kkaya674/AntiaTech/Others/Çizimler/raspBi_box/images/DSC_0020.JPG

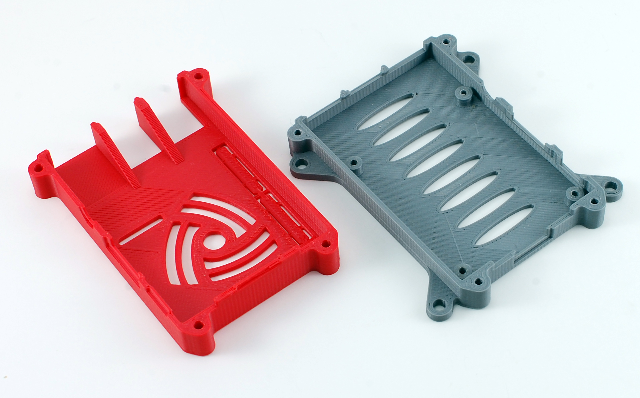
Others/Çizimler/raspBi_box/images/DSC_0020.JPG
