kkaya674/AntiaTech/Others/Çizimler/raspBi_box/images/DSC_0039.JPG

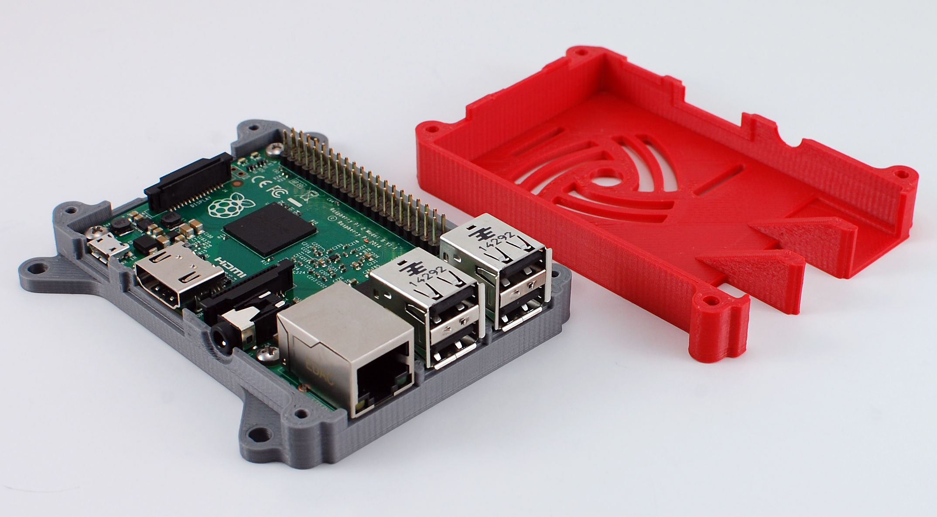
Others/Çizimler/raspBi_box/images/DSC_0039.JPG
