kkaya674/AntiaTech/README.md

# AntiaTech
EE493 Project

Afer Olkay Başak Koca Çağrı Arı Kubilay Kaya Rana Böğrekci
