kkaya674/AntiaTech/Others/Arduino_Vibration&Servo/README

These codes are for the communication between Arduino and other components.
