kkaya674/AntiaTech/Others/MotorSürücü/Faydalı Şeyler/Ekran Resmi 2022-11-27 14.13.48.png

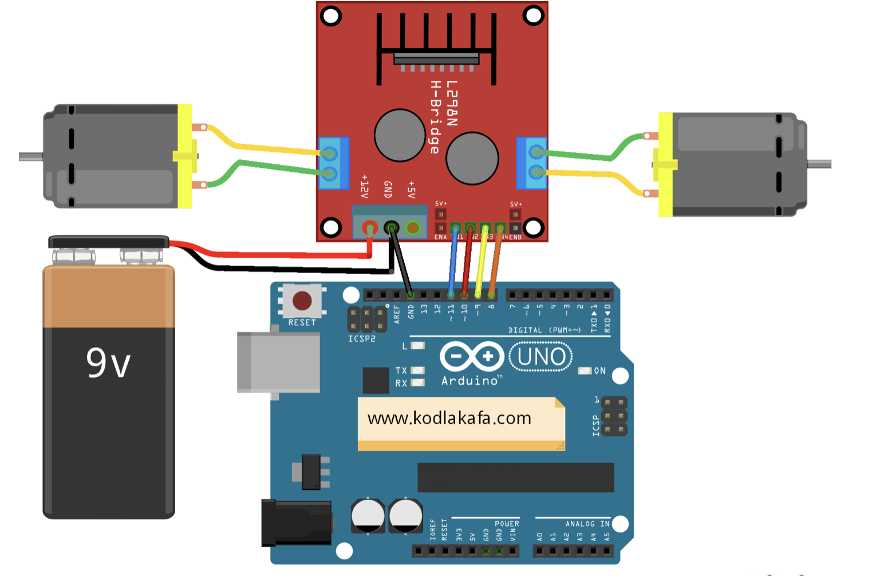
Others/MotorSürücü/Faydalı Şeyler/Ekran Resmi 2022-11-27 14.13.48.png
