kkaya674/AntiaTech/Others/Çizimler/raspBi_box/images/25mm-no-fan.png

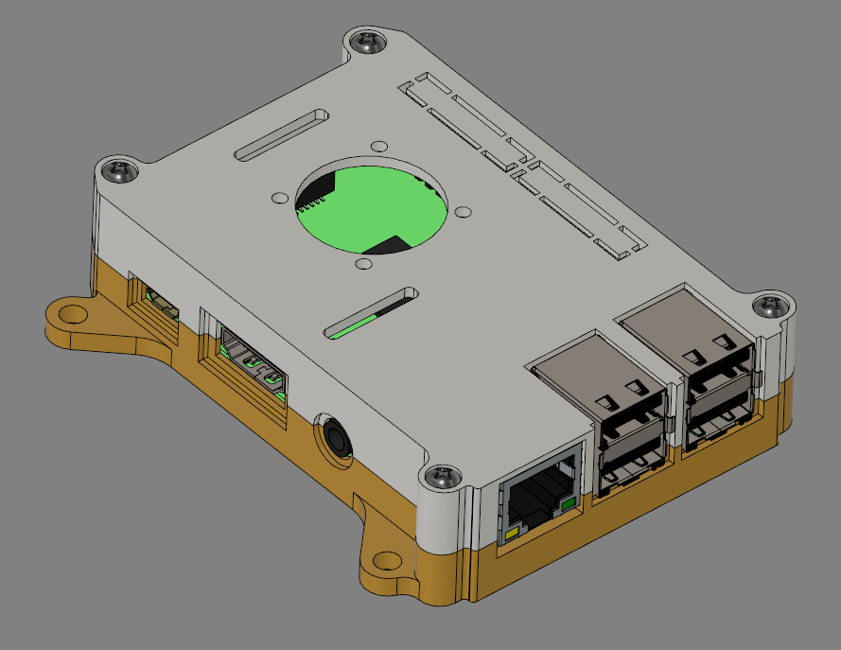
Others/Çizimler/raspBi_box/images/25mm-no-fan.png
