kkaya674/AntiaTech/Others/Çizimler/raspBi_box/images/100mm-VESA.png

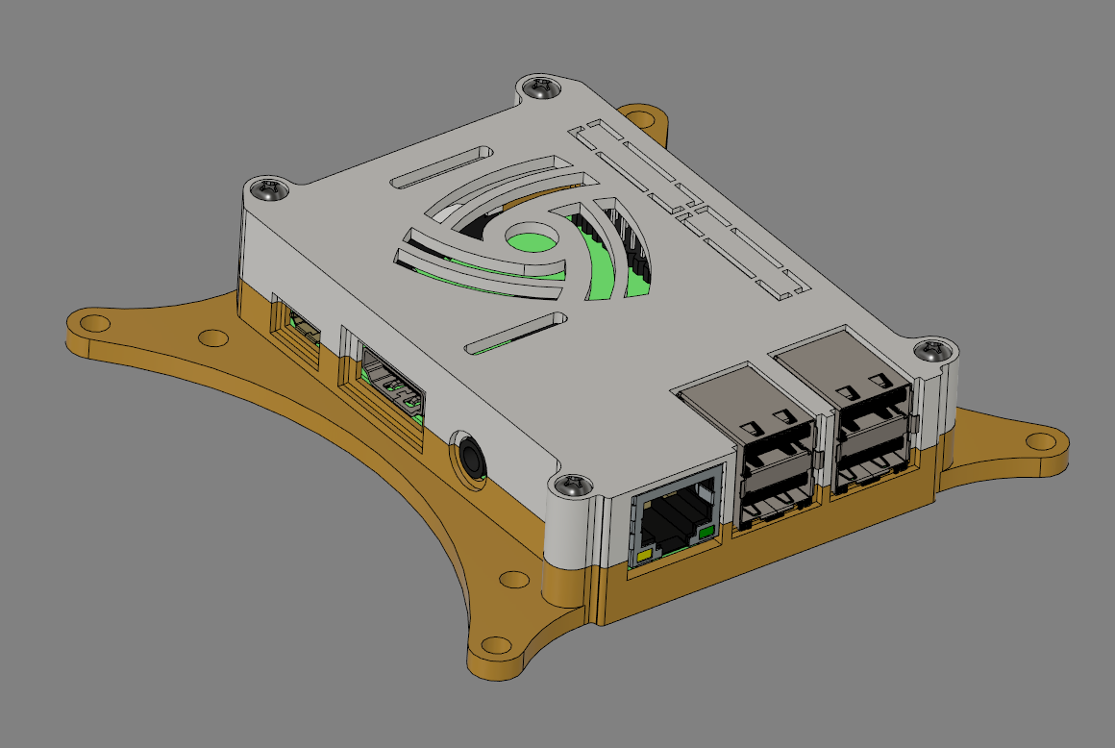
Others/Çizimler/raspBi_box/images/100mm-VESA.png
