kkaya674/AntiaTech/Others/Çizimler/raspBi_box/images/8020-mount.png

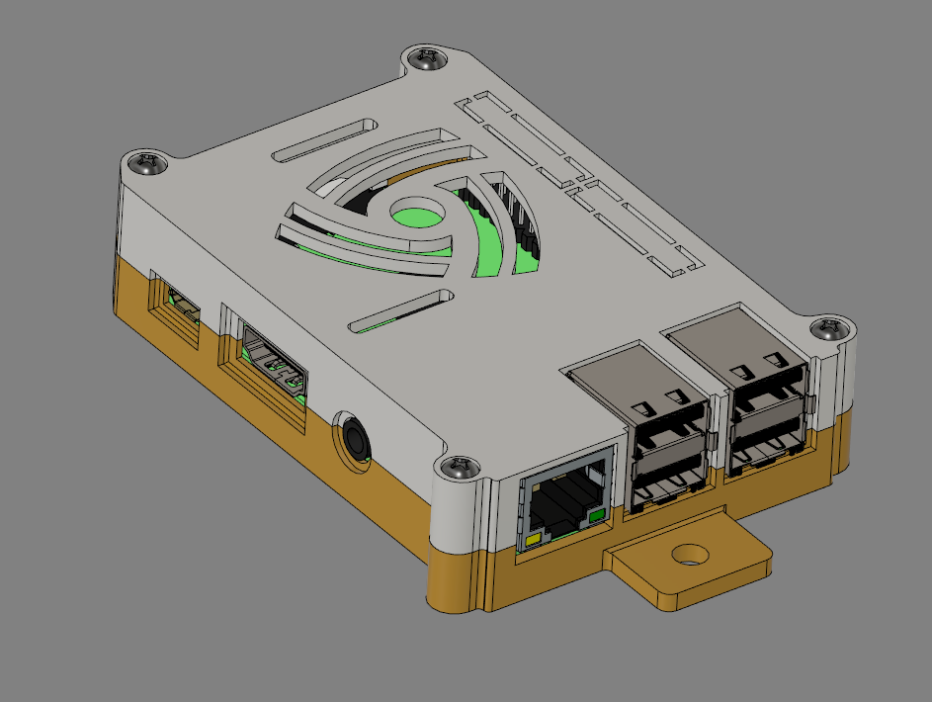
Others/Çizimler/raspBi_box/images/8020-mount.png
