kkaya674/AntiaTech/Others/Çizimler/raspBi_box/images/DSC_0007.JPG

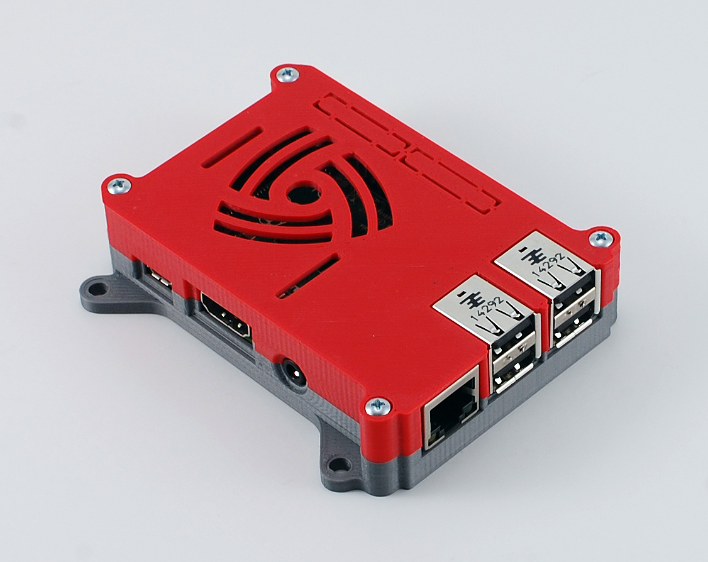
Others/Çizimler/raspBi_box/images/DSC_0007.JPG
