kkaya674/AntiaTech/Others/Çizimler/raspBi_box/images/DSC_0016.JPG

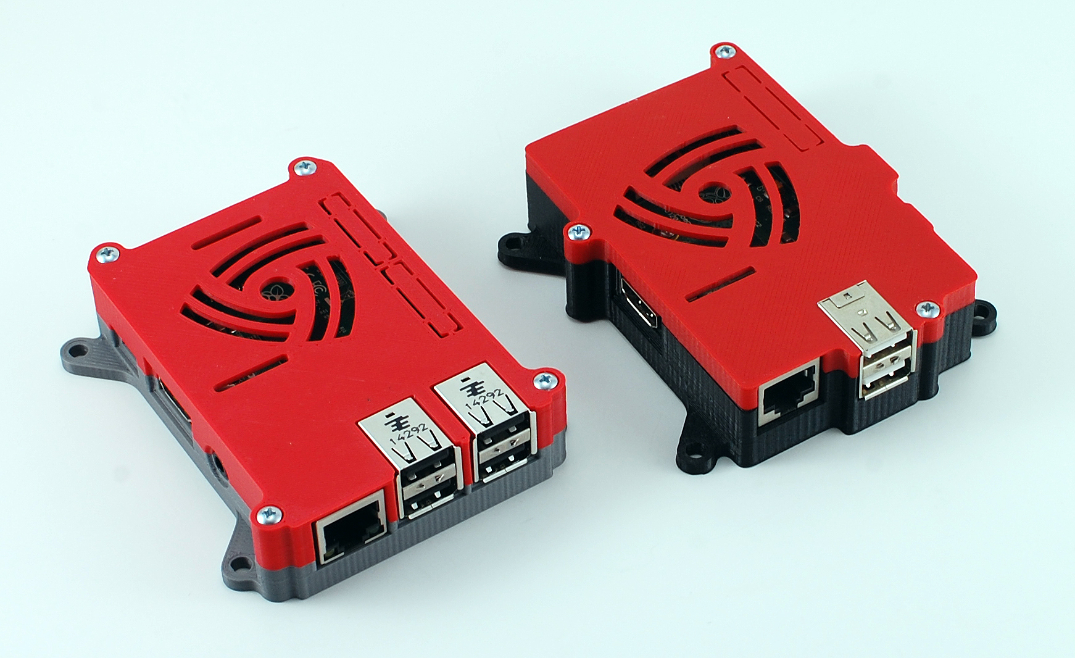
Others/Çizimler/raspBi_box/images/DSC_0016.JPG
