kkaya674/AntiaTech/Others/Çizimler/raspBi_box/images/DSC_0027.JPG

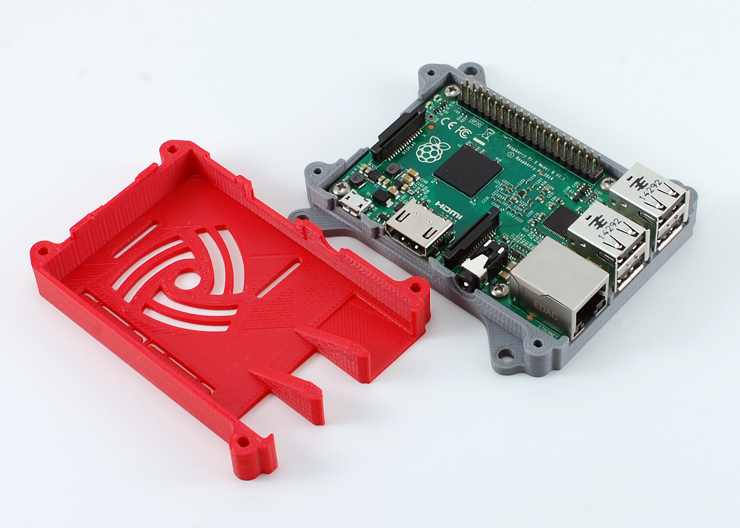
Others/Çizimler/raspBi_box/images/DSC_0027.JPG
