kkaya674/AntiaTech/Others/Çizimler/raspBi_box/images/rpi2-bottom_100mm-vesa_netfabb.png

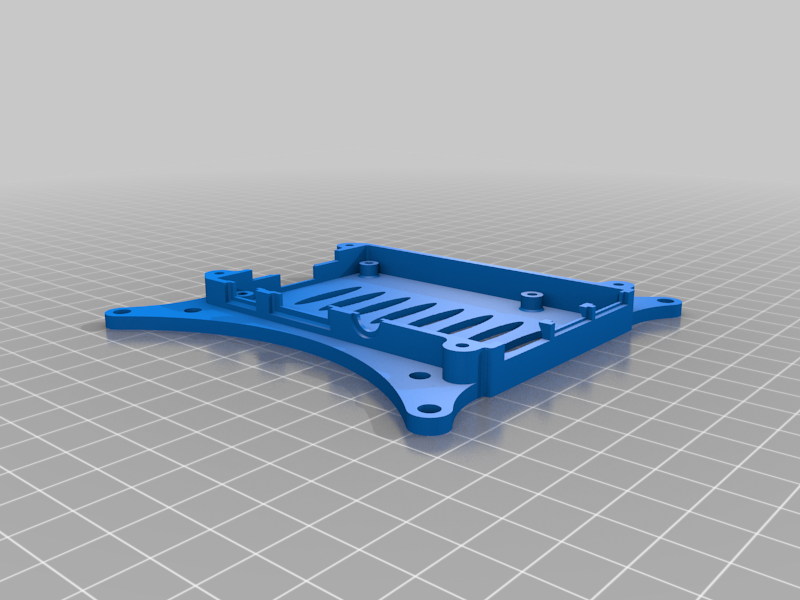
Others/Çizimler/raspBi_box/images/rpi2-bottom_100mm-vesa_netfabb.png
