kkaya674/AntiaTech/Others/Çizimler/raspBi_box/images/RPi2-case_stl.JPG

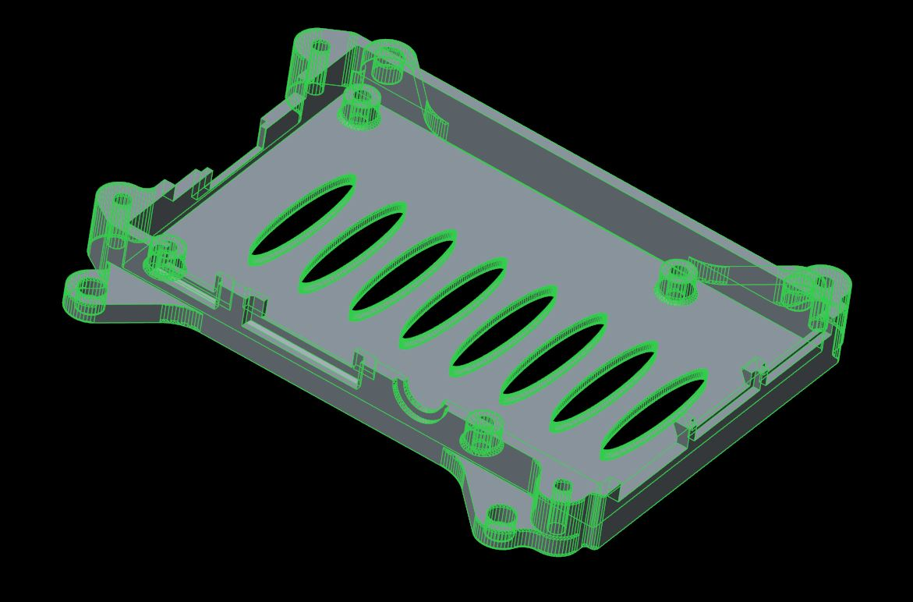
Others/Çizimler/raspBi_box/images/RPi2-case_stl.JPG
