kkaya674/AntiaTech/Others/Çizimler/raspBi_box/images/rpi2-top_netfabb.png

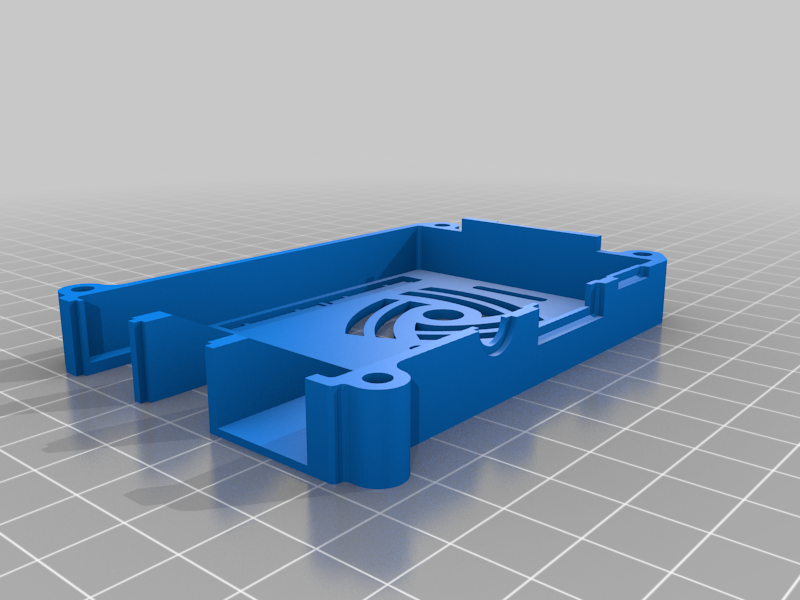
Others/Çizimler/raspBi_box/images/rpi2-top_netfabb.png
