kkaya674/AntiaTech/Others/Çizimler/raspBi_box/images/RPi-1.JPG

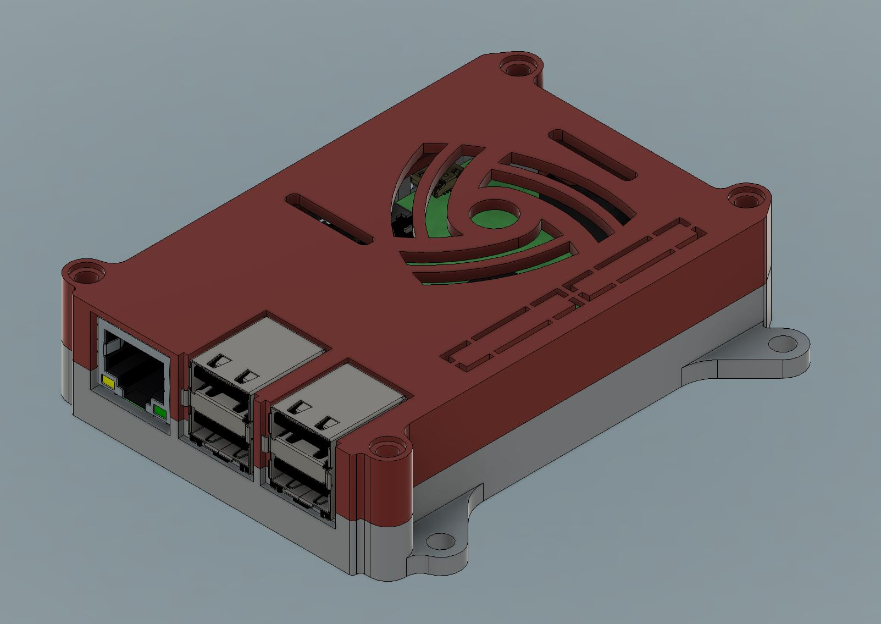
Others/Çizimler/raspBi_box/images/RPi-1.JPG
