kkaya674/AntiaTech/Others/Çizimler/raspBi_box/images/Standard_75mm-VESA.png

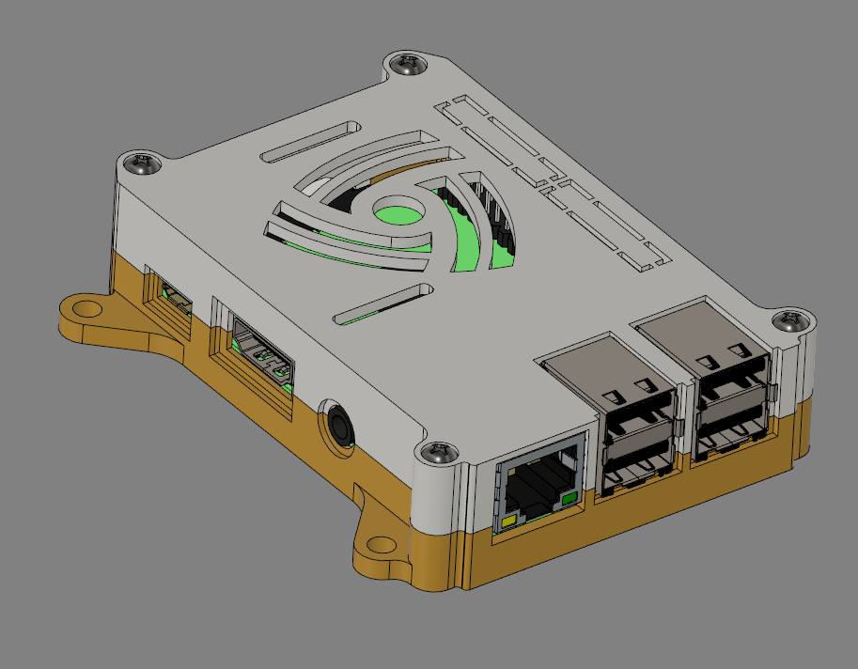
Others/Çizimler/raspBi_box/images/Standard_75mm-VESA.png
