kkaya674/AntiaTech/Reports/grafikler/Number of Ball per 15 Seconds vs Motor Voltage.png

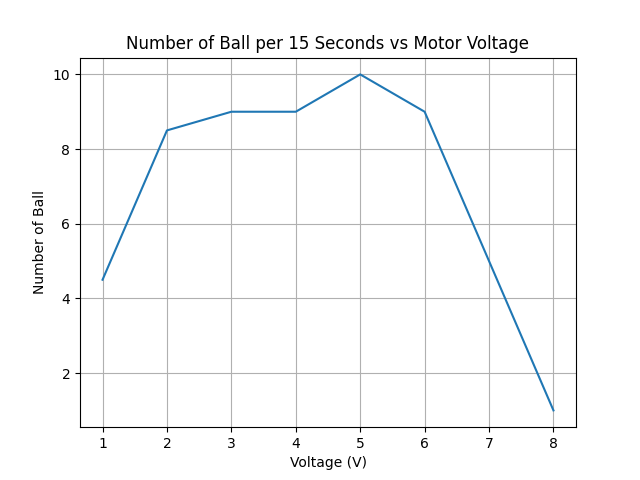
Reports/grafikler/Number of Ball per 15 Seconds vs Motor Voltage.png
