kkaya674/AntiaTech/Reports/grafikler/Speed vs Current.png

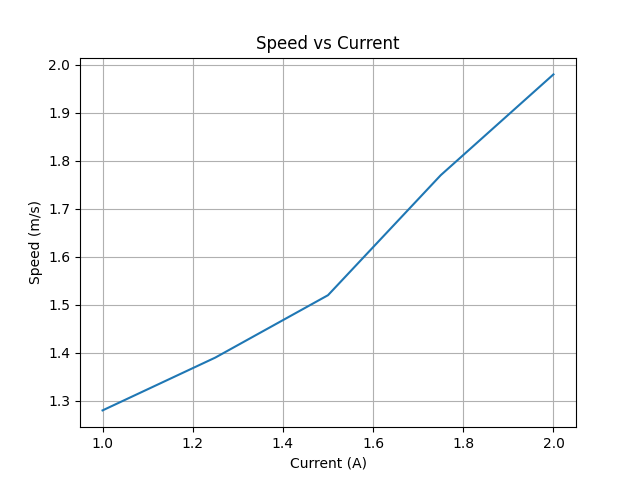
Reports/grafikler/Speed vs Current.png
