kkaya674/AntiaTech/TableTennisBallTracker/resources/renkliToplar.png

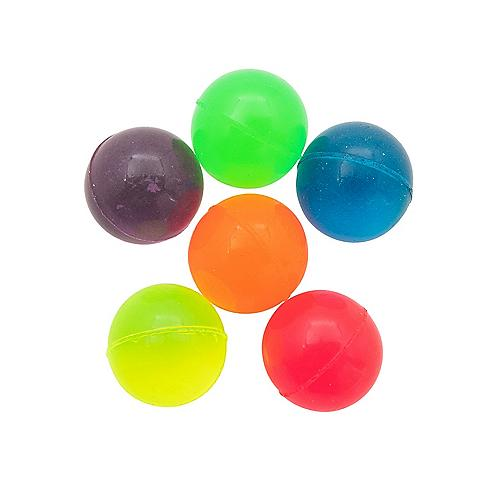
TableTennisBallTracker/resources/renkliToplar.png
