kkaya674/AntiaTech/Others/MotorSürücü/yeniNamlu_obj_raw.stl

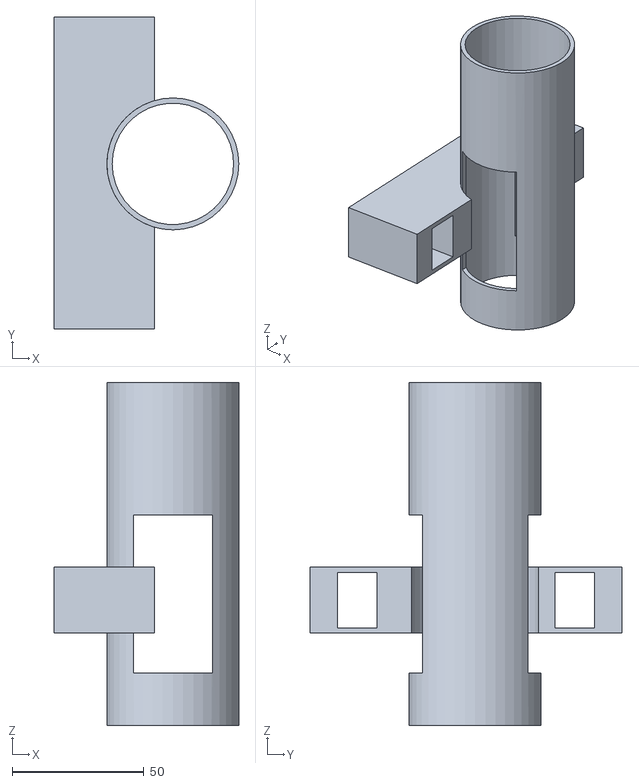
[picture p49: CAD file, 2022-12-27]
Others/MotorSürücü/yeniNamlu_obj_raw.stl
70.0 x 118.3 x 130.0
