kkaya674/AntiaTech/Others/Çizimler/motor yuvası vertical v3.stl

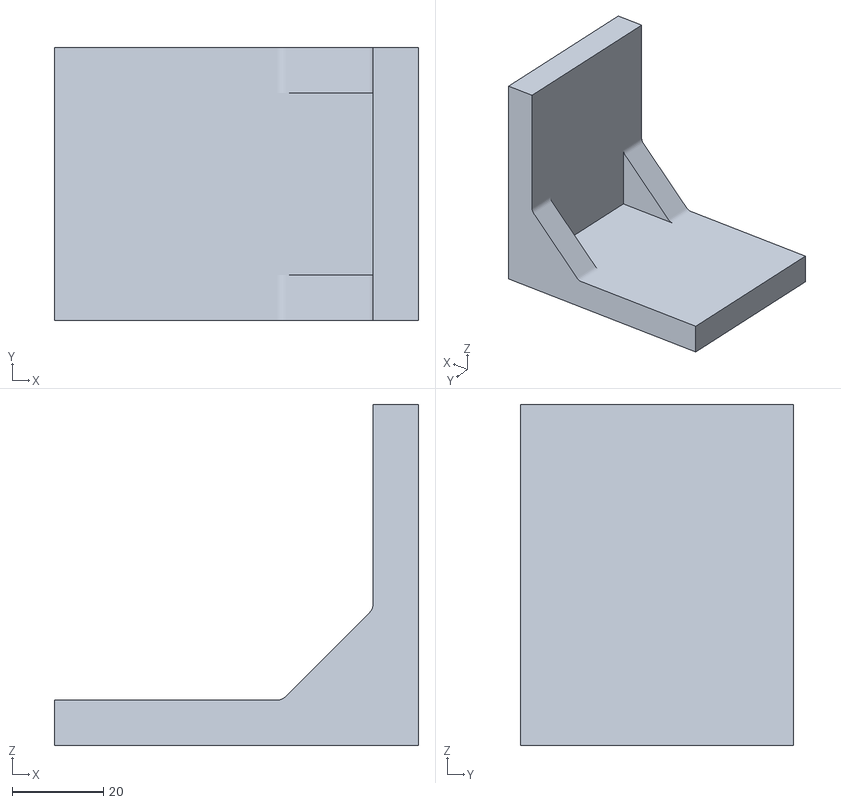
[picture p50: CAD file, 2023-05-10]
Others/Çizimler/motor yuvası vertical v3.stl
80.0 x 60.0 x 75.0
