kkaya674/AntiaTech/Others/Çizimler/raspBi_box/files/rpi2-top.stp

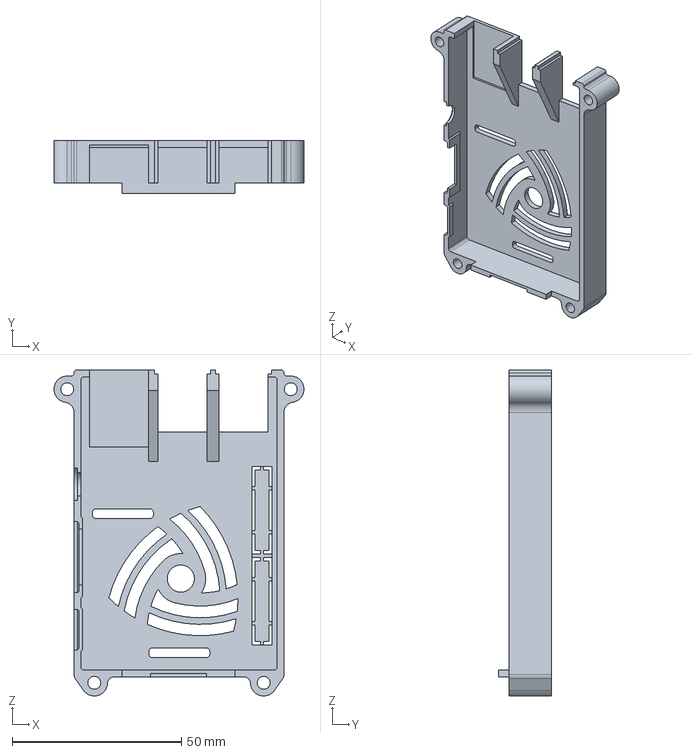
[picture p51: CAD file, 2023-05-13]
Others/Çizimler/raspBi_box/files/rpi2-top.stp
73.8 x 15.5 x 96.2 mm
