kkaya674/AntiaTech/YeniÇizimler/motoryuva2.stl

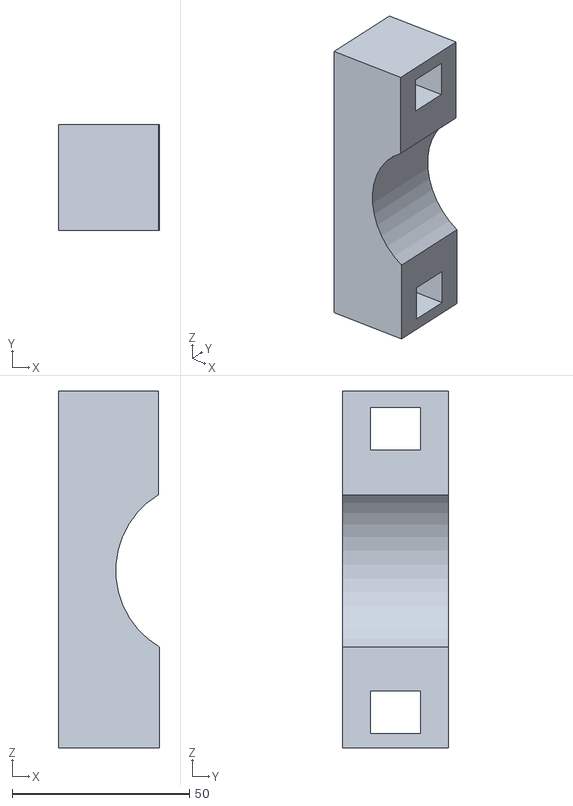
[picture p52: CAD file, 2023-05-27]
YeniÇizimler/motoryuva2.stl
28.6 x 30.0 x 100.6
