kkaya674/AntiaTech/Others/Çizimler/raspBi_box/files/rpi3-bottom.stp

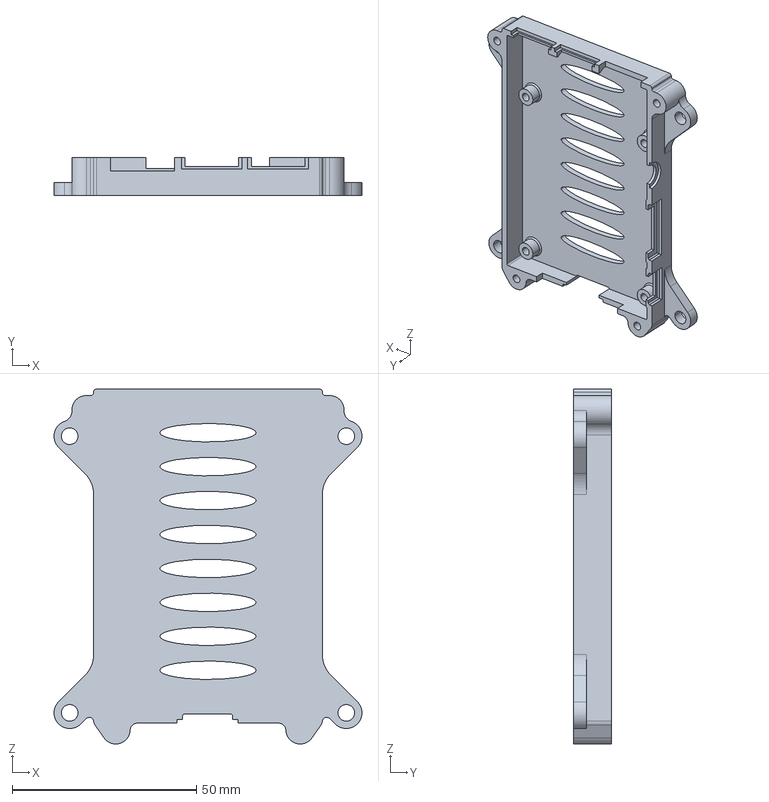
[picture p53: CAD file, 2023-05-13]
Others/Çizimler/raspBi_box/files/rpi3-bottom.stp
83.5 x 10.3 x 96.2 mm
