kkaya674/AntiaTech/Others/Çizimler/yeniNamluBaglanti3.stl

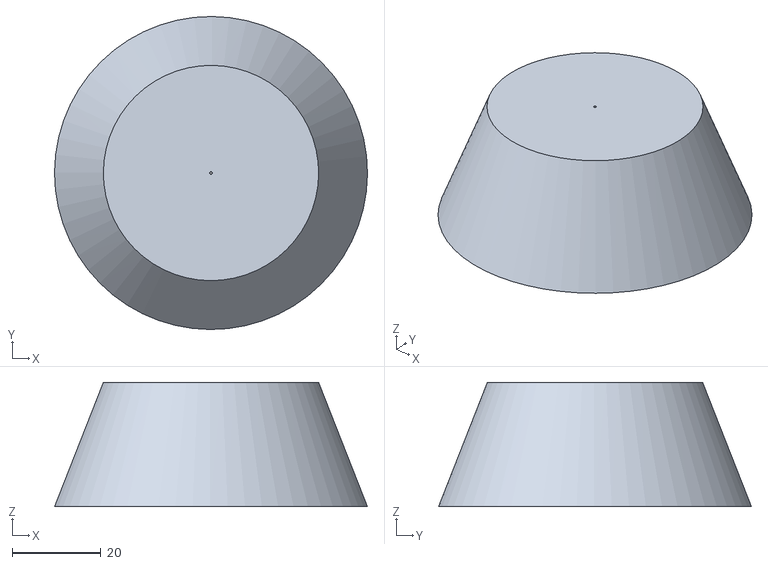
[picture p54: CAD file, 2023-04-25]
Others/Çizimler/yeniNamluBaglanti3.stl
70.5 x 70.5 x 28.0
