kkaya674/AntiaTech/YeniÇizimler/namluUcutube_2.stl

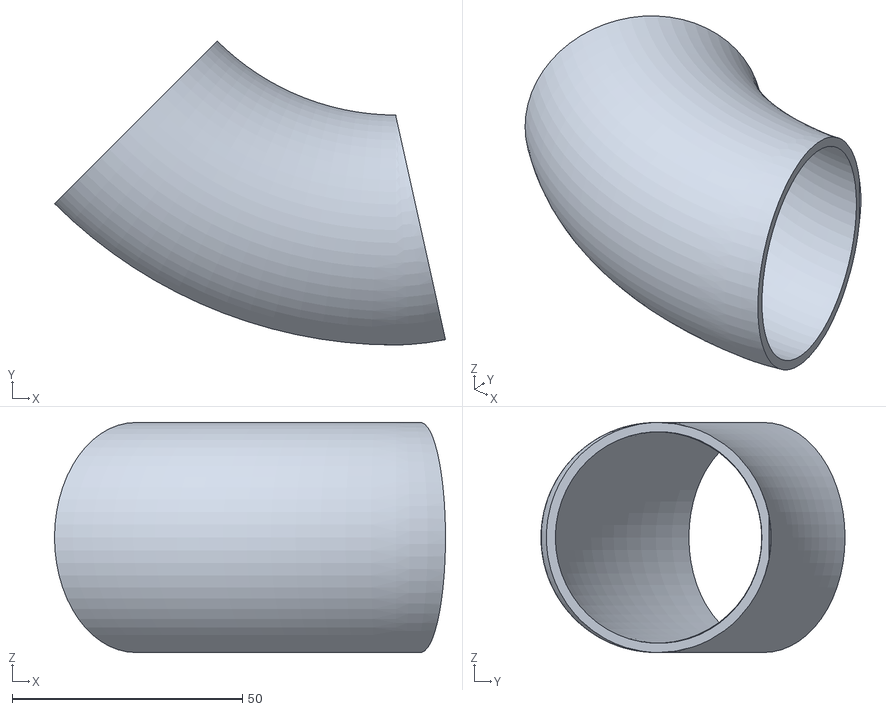
[picture p55: CAD file, 2023-05-27]
YeniÇizimler/namluUcutube_2.stl
85.0 x 66.1 x 50.0
