kkaya674/AntiaTech/Others/Çizimler/yeniNamluBaglanti1.stl

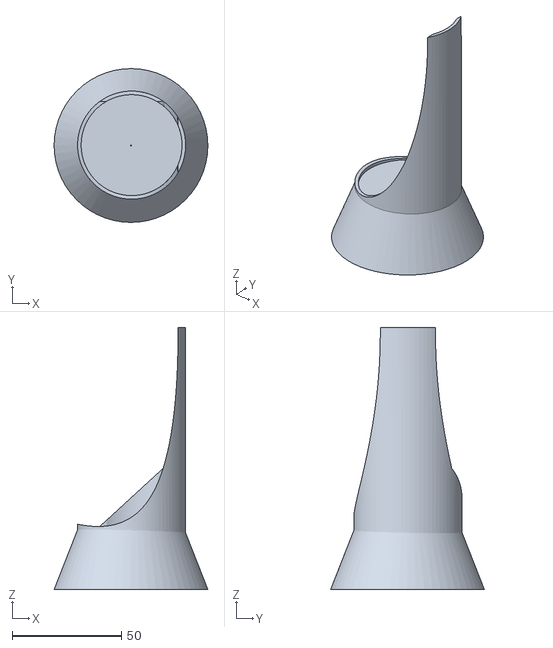
[picture p56: CAD file, 2023-04-25]
Others/Çizimler/yeniNamluBaglanti1.stl
70.5 x 70.5 x 120.0
