kkaya674/AntiaTech/YeniÇizimler/namluUcutube_1.stl

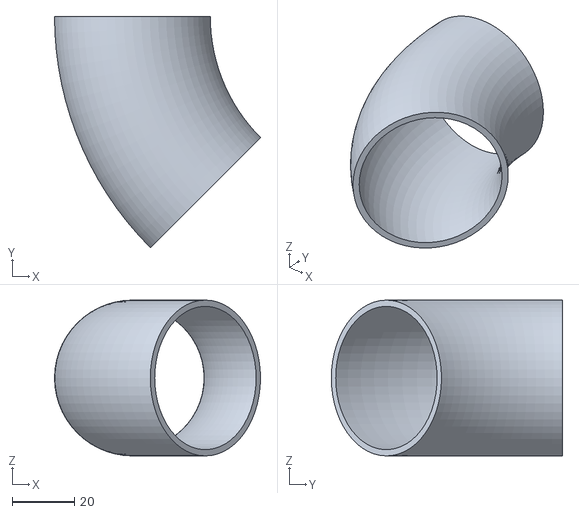
[picture p57: CAD file, 2023-05-27]
YeniÇizimler/namluUcutube_1.stl
66.1 x 74.2 x 50.0
