kkaya674/AntiaTech/Others/Çizimler/horizontal_kasnak v2.stl

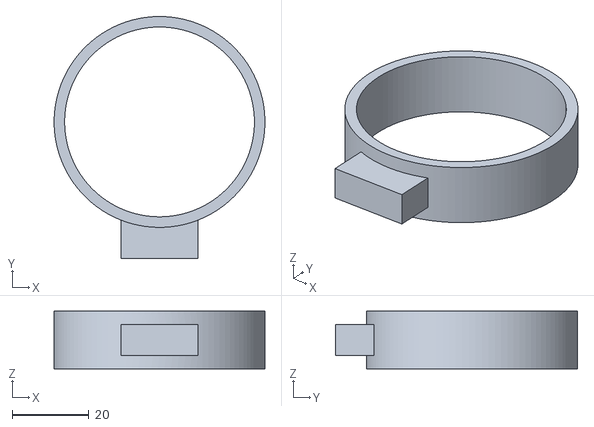
[picture p58: CAD file, 2023-03-21]
Others/Çizimler/horizontal_kasnak v2.stl
55.0 x 63.1 x 15.0
