kkaya674/AntiaTech/Others/Çizimler/raspBi_box/files/rpi2-top_30mm-fan_netfabb.stl

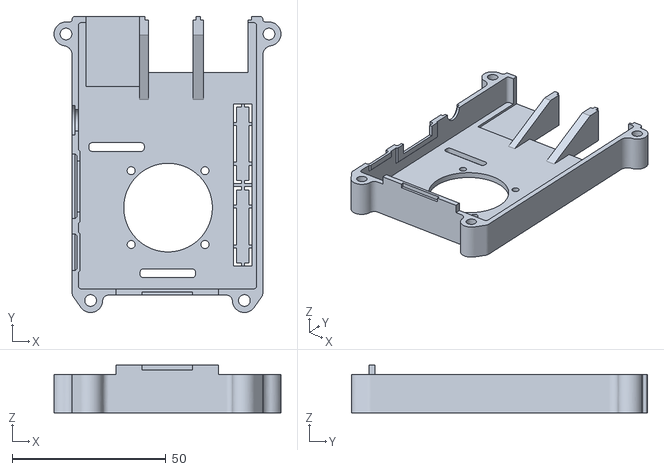
[picture p59: CAD file, 2022-12-03]
Others/Çizimler/raspBi_box/files/rpi2-top_30mm-fan_netfabb.stl
73.8 x 96.2 x 15.5
