kkaya674/AntiaTech/YeniÇizimler/namluBirlesimi.stl

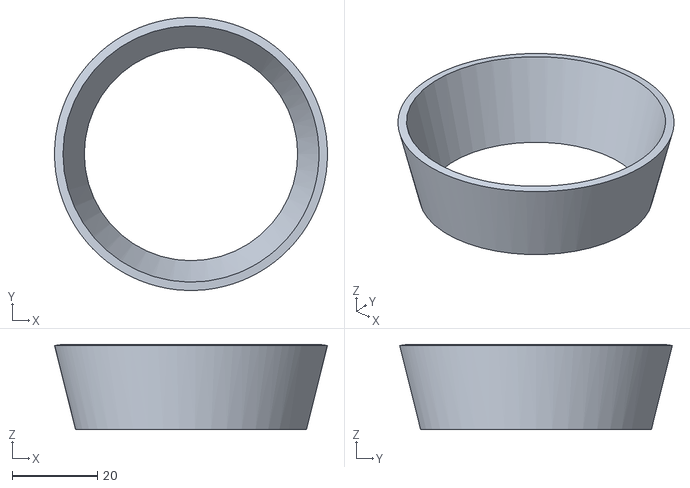
[picture p60: CAD file, 2023-05-27]
YeniÇizimler/namluBirlesimi.stl
64.0 x 63.9 x 20.0
