kkaya674/AntiaTech/YeniÇizimler/namlu2.stl

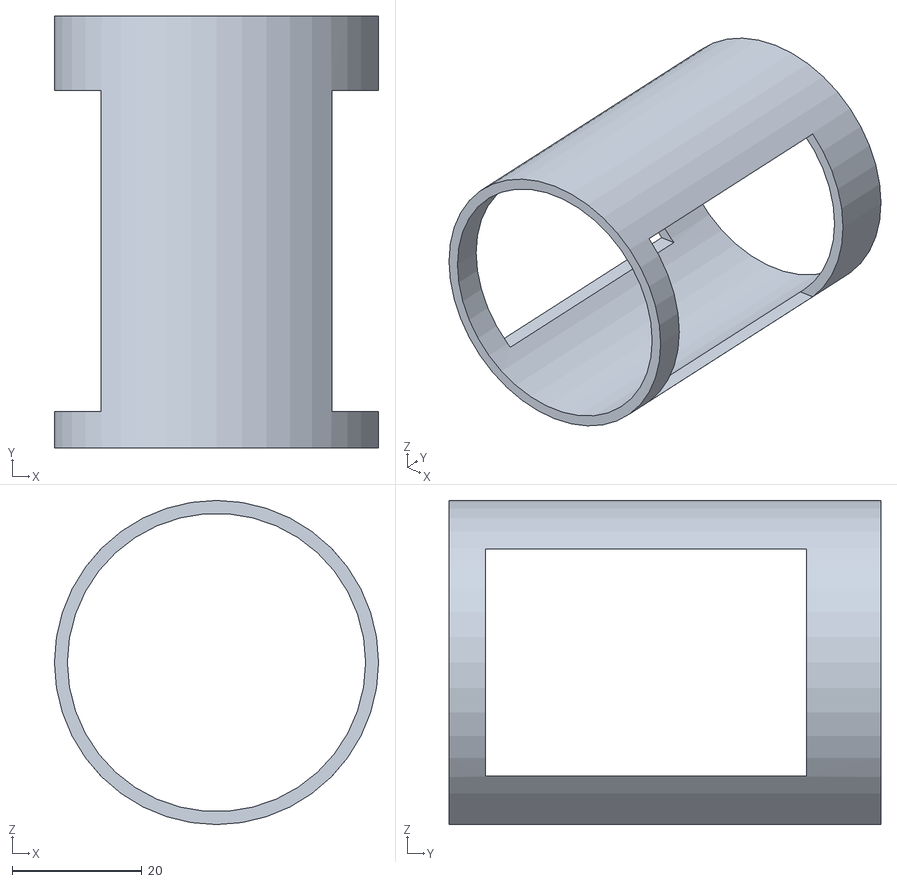
[picture p61: CAD file, 2023-05-27]
YeniÇizimler/namlu2.stl
50.0 x 66.6 x 50.0
