kkaya674/AntiaTech/Others/Çizimler/NamluKoprusu v0.stl

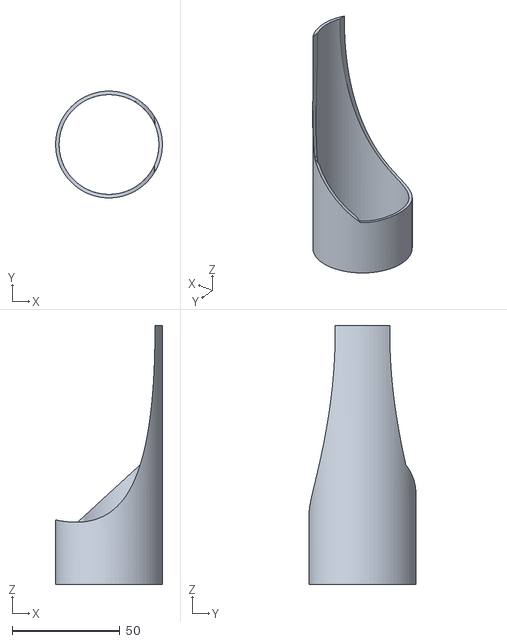
[picture p62: CAD file, 2022-12-19]
Others/Çizimler/NamluKoprusu v0.stl
49.5 x 49.5 x 120.0
