kkaya674/AntiaTech/Others/Çizimler/DiskMotoruYatagi v1.stl

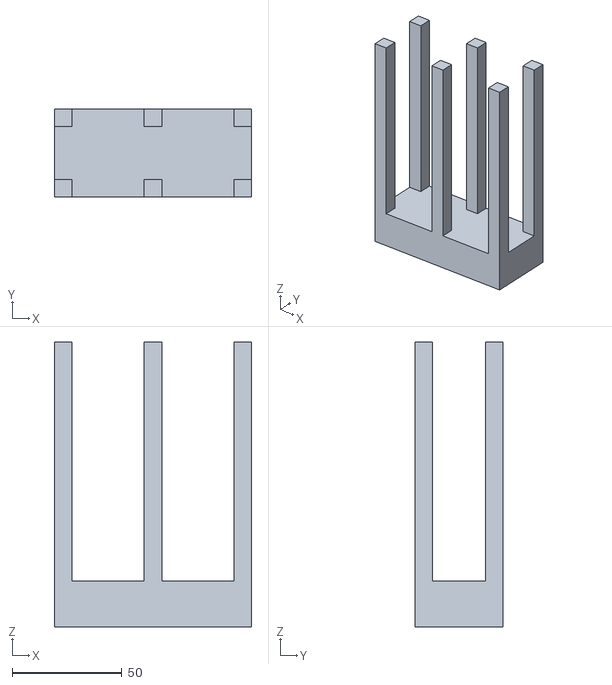
[picture p63: CAD file, 2022-12-19]
Others/Çizimler/DiskMotoruYatagi v1.stl
90.0 x 40.0 x 130.0
