kkaya674/AntiaTech/Others/Çizimler/raspBi_box/files/rpi2-bottom_8020_netfabb.stl

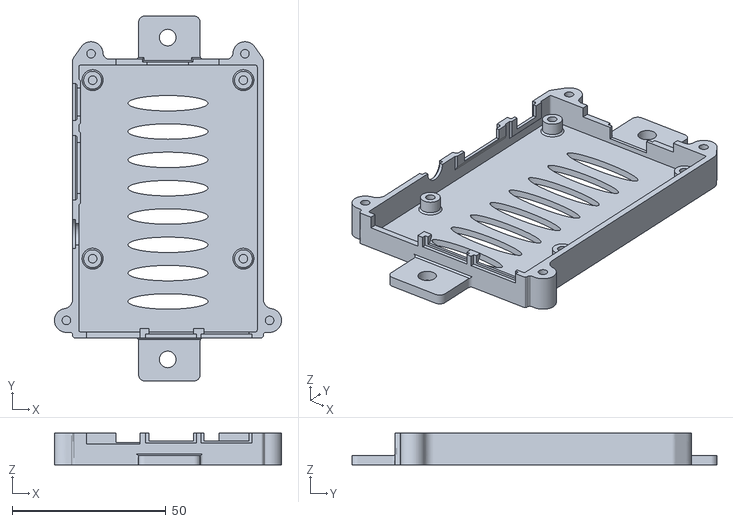
[picture p64: CAD file, 2022-12-03]
Others/Çizimler/raspBi_box/files/rpi2-bottom_8020_netfabb.stl
73.8 x 118.6 x 10.3
