kkaya674/AntiaTech/Others/Çizimler/namlıKovaBaglanti.stl

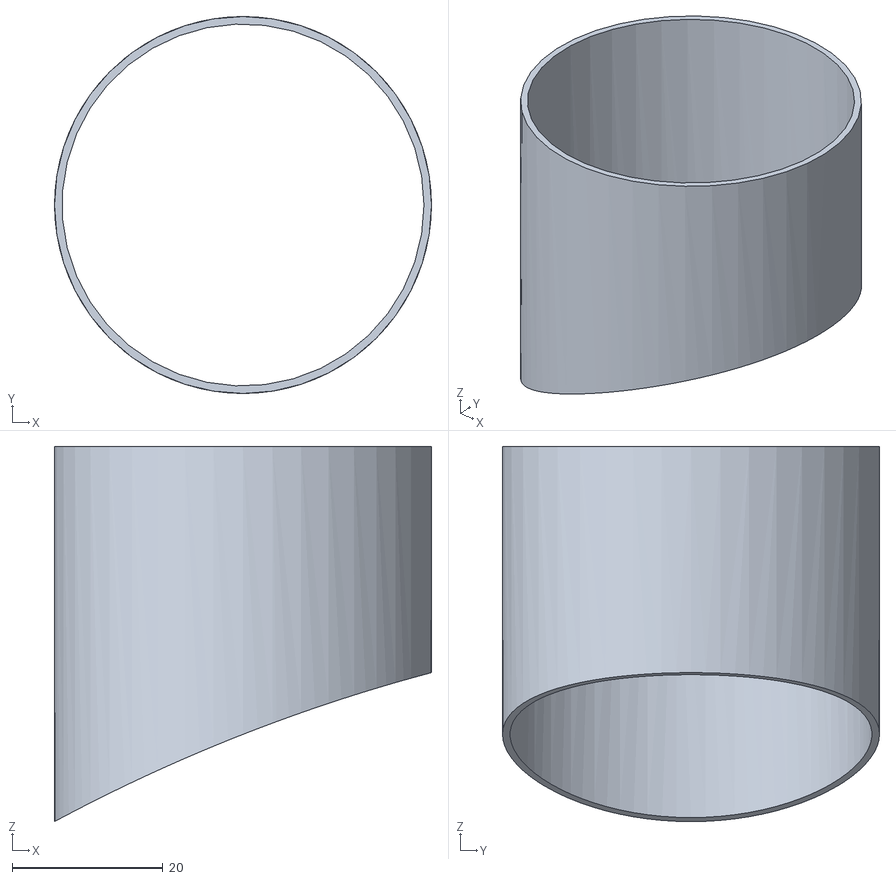
[picture p65: CAD file, 2022-12-19]
Others/Çizimler/namlıKovaBaglanti.stl
50.0 x 50.0 x 49.8
