kkaya674/AntiaTech/Others/Çizimler/raspBi_box/files/rpi3-bottom_100mm-vesa_netfabb.stl

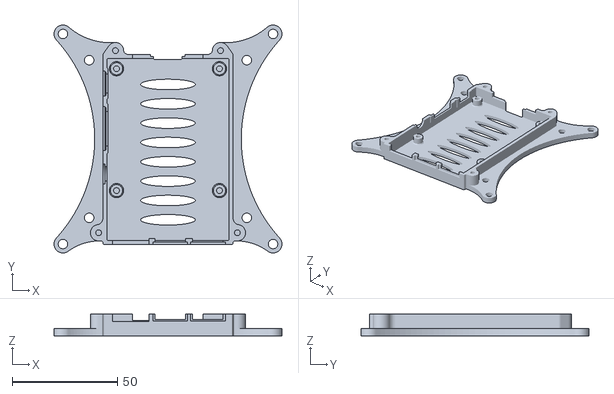
[picture p66: CAD file, 2022-12-03]
Others/Çizimler/raspBi_box/files/rpi3-bottom_100mm-vesa_netfabb.stl
108.5 x 108.5 x 10.3
