kkaya674/AntiaTech/Others/Çizimler/yeniNamlu_obj_raw_1.stl

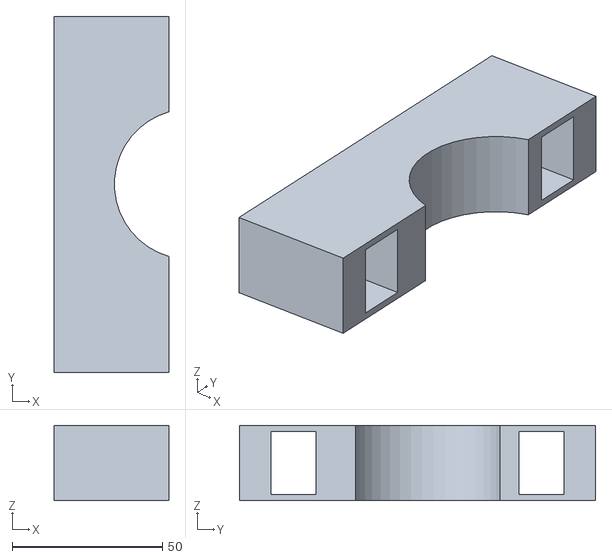
[picture p67: CAD file, 2022-12-18]
Others/Çizimler/yeniNamlu_obj_raw_1.stl
38.1 x 118.3 x 25.0
