kkaya674/AntiaTech/Others/Çizimler/tekerJant.stl

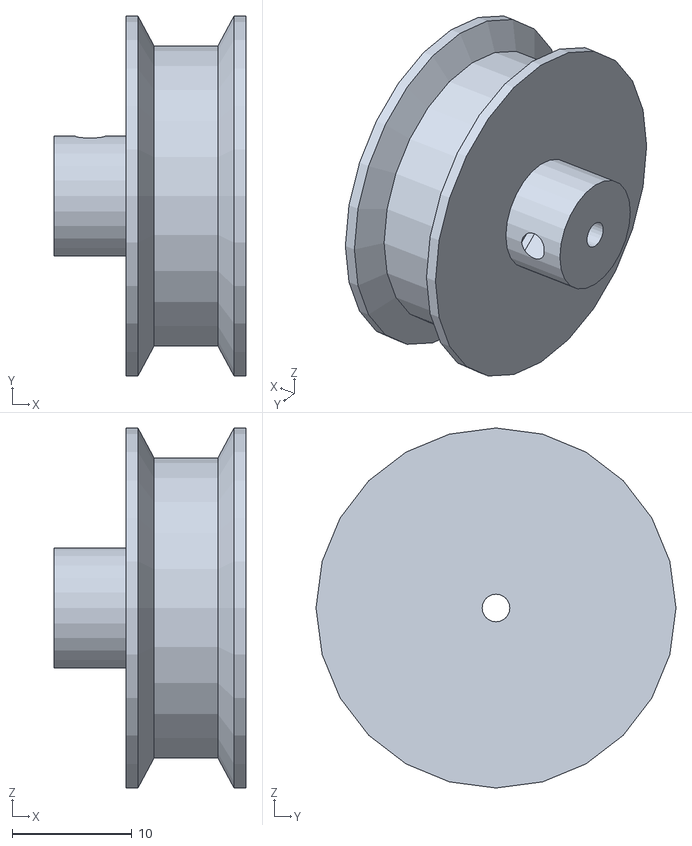
[picture p68: CAD file, 2022-12-09]
Others/Çizimler/tekerJant.stl
16.0 x 30.0 x 30.0
