kkaya674/AntiaTech/Others/Çizimler/namluKovayaGiren.stl

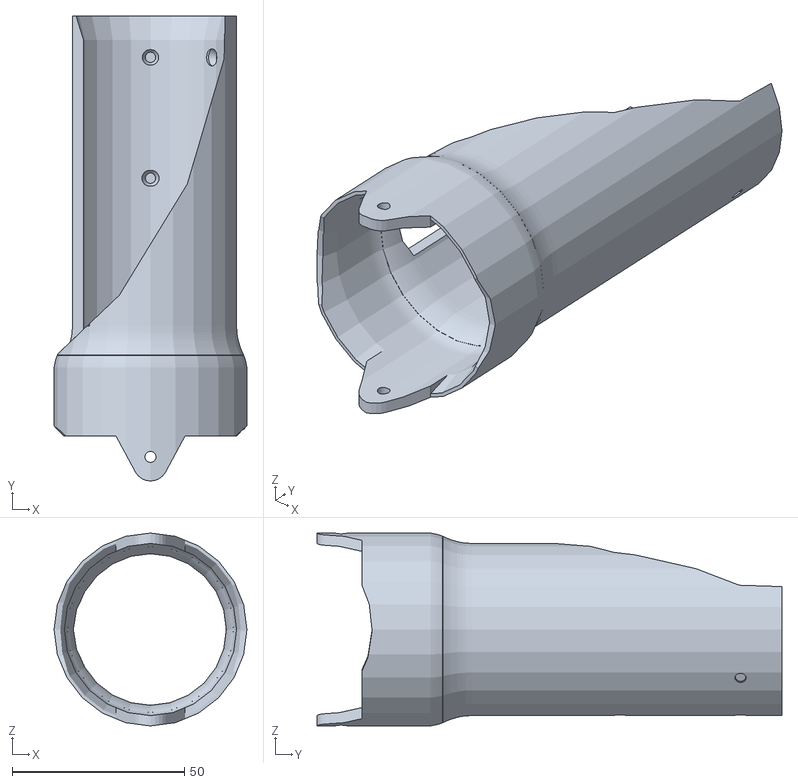
[picture p69: CAD file, 2022-12-09]
Others/Çizimler/namluKovayaGiren.stl
56.0 x 135.0 x 56.0
