kkaya674/AntiaTech/Others/Çizimler/namluBaglanti.stl

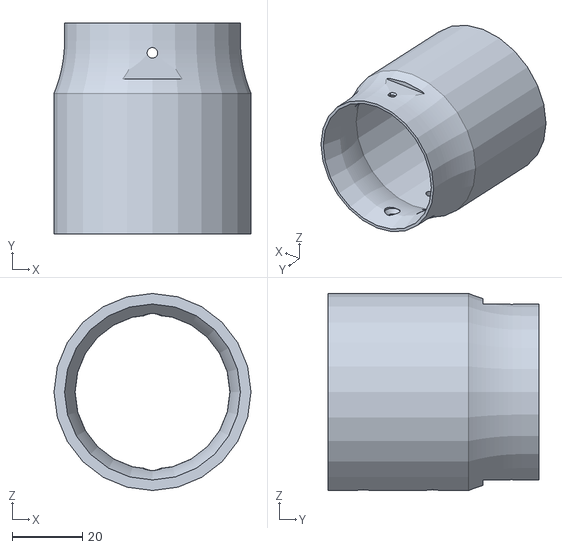
[picture p70: CAD file, 2022-12-09]
Others/Çizimler/namluBaglanti.stl
56.0 x 60.0 x 56.0
