kkaya674/AntiaTech/Others/Çizimler/namluUcuSon.stl

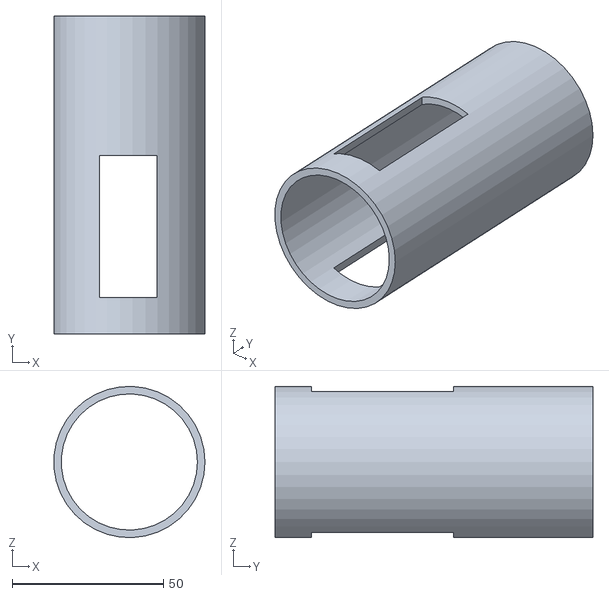
[picture p71: CAD file, 2022-12-09]
Others/Çizimler/namluUcuSon.stl
49.9 x 105.0 x 50.0
