kkaya674/AntiaTech/Others/Çizimler/alttaban_filled v1 (2).stl

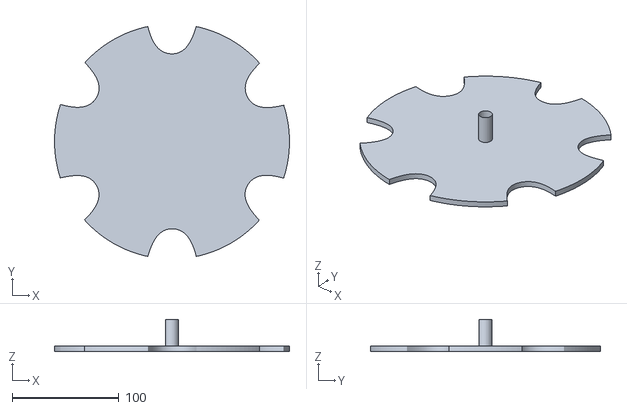
[picture p72: CAD file, 2022-12-07]
Others/Çizimler/alttaban_filled v1 (2).stl
220.0 x 215.3 x 30.0
