kkaya674/AntiaTech/Others/Çizimler/alttabanson.stl

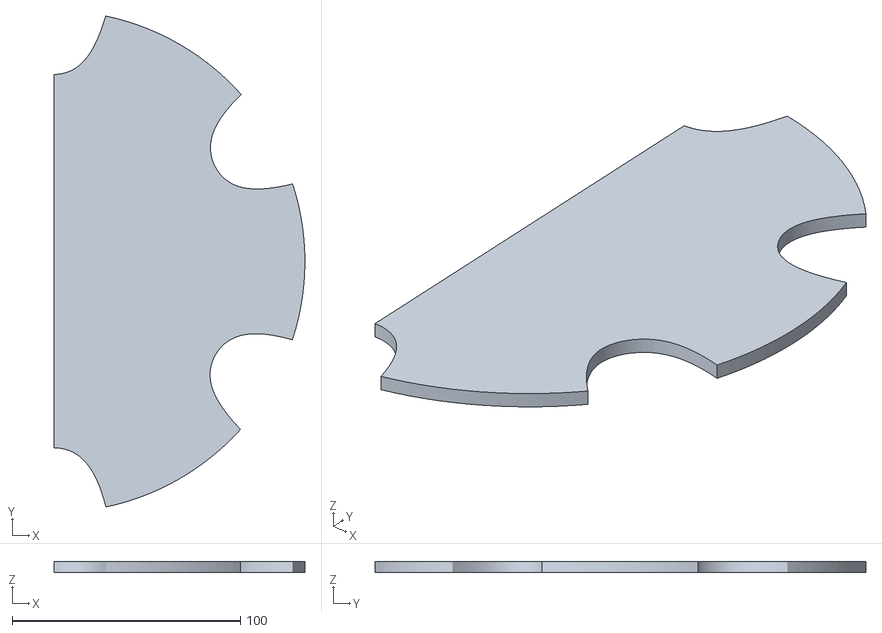
[picture p73: CAD file, 2022-12-07]
Others/Çizimler/alttabanson.stl
110.0 x 215.3 x 5.00
