kkaya674/AntiaTech/Others/Çizimler/motorYuva.stl

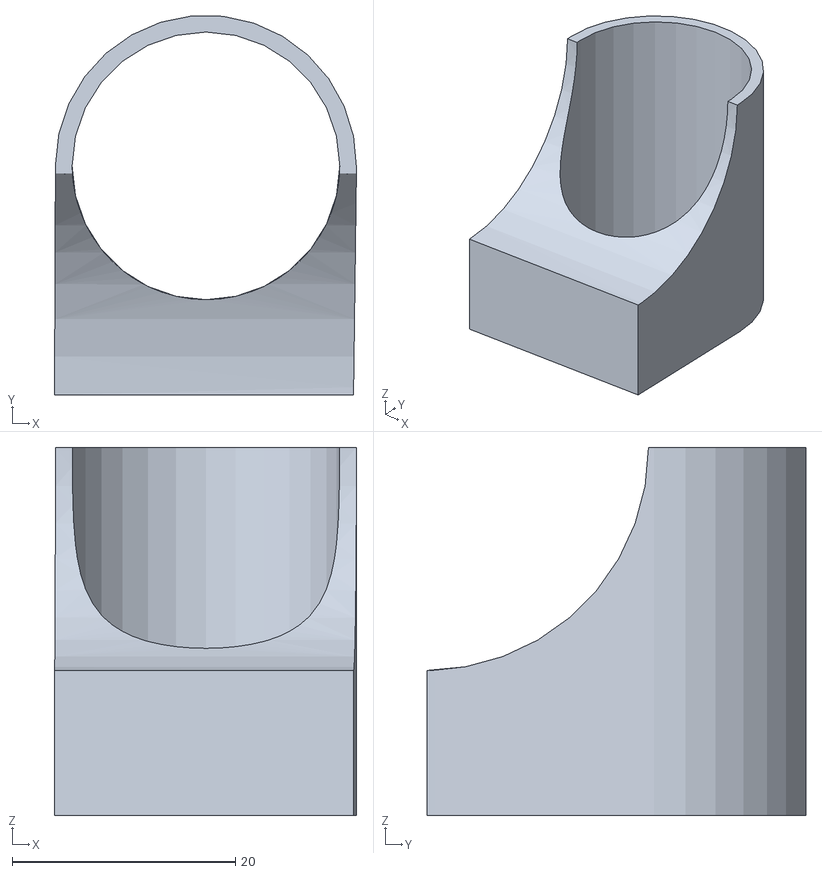
[picture p74: CAD file, 2022-12-07]
Others/Çizimler/motorYuva.stl
27.1 x 34.0 x 33.0
