kkaya674/AntiaTech/Others/Çizimler/VidaCarkiv1.stl

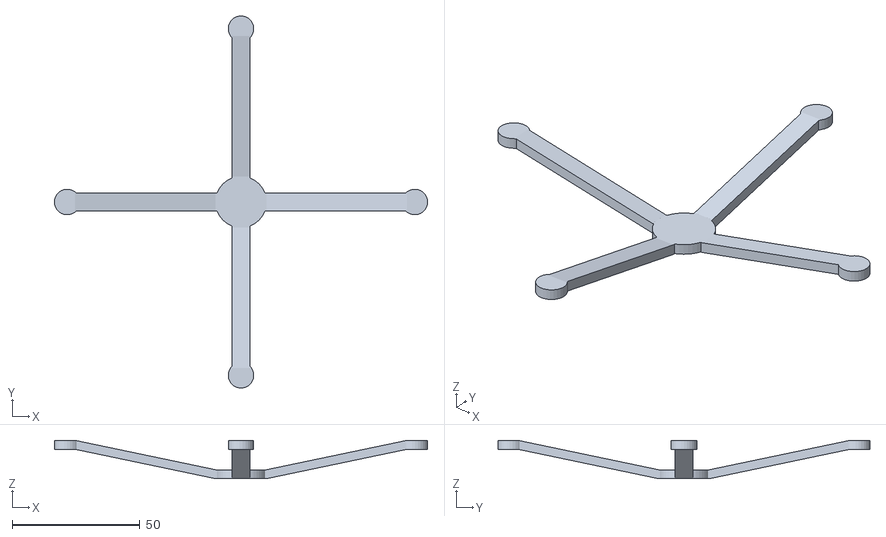
[picture p75: CAD file, 2022-12-06]
Others/Çizimler/VidaCarkiv1.stl
146.1 x 145.6 x 15.0
