kkaya674/AntiaTech/Others/Çizimler/yeniNamlu.stl

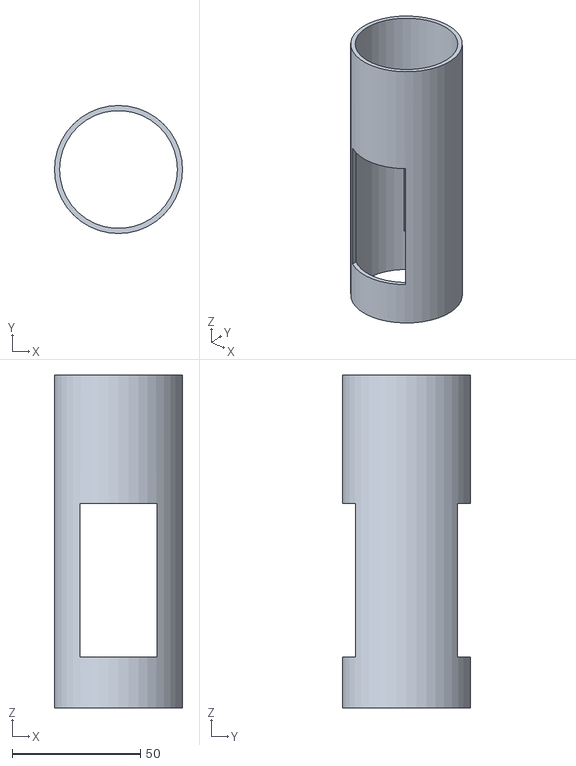
[picture p76: CAD file, 2022-12-06]
Others/Çizimler/yeniNamlu.stl
50.0 x 50.0 x 130.0
