kkaya674/AntiaTech/Others/Çizimler/namluUcu.stl

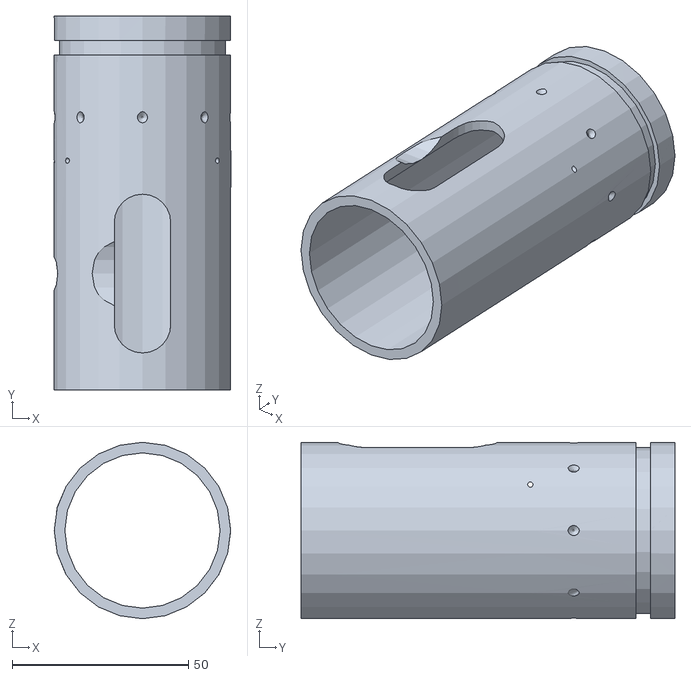
[picture p77: CAD file, 2022-12-03]
Others/Çizimler/namluUcu.stl
50.0 x 106.0 x 50.0
