kkaya674/AntiaTech/(list of files, cad)

Other CAD files:
Others/Çizimler/raspBi_box/files/rpi2-bottom.stp
Others/Çizimler/raspBi_box/files/rpi3-bottom_netfabb.stl
Others/Çizimler/raspBi_box/files/rpi2-top_25mm-fan_netfabb.stl
Others/Çizimler/raspBi_box/files/rpi2-bottom_100mm-vesa_netfabb.stl
Others/MotorSürücü/yeniNamlu_obj_raw.prt
Others/Çizimler/3D_CAD_model_Training_Buddy v4.f3d
Others/Çizimler/3D_CAD_model_Training_Buddy v8.f3d
Others/Çizimler/yeniyuvaprt.prt
YeniÇizimler/namluUcutube.prt
YeniÇizimler/namlubirlesimi.prt
YeniÇizimler/yeniNamlu.prt
