kkaya674/AntiaTech/Reports/grafikler/Temperature vs Current for 1 Minute of Operation.png

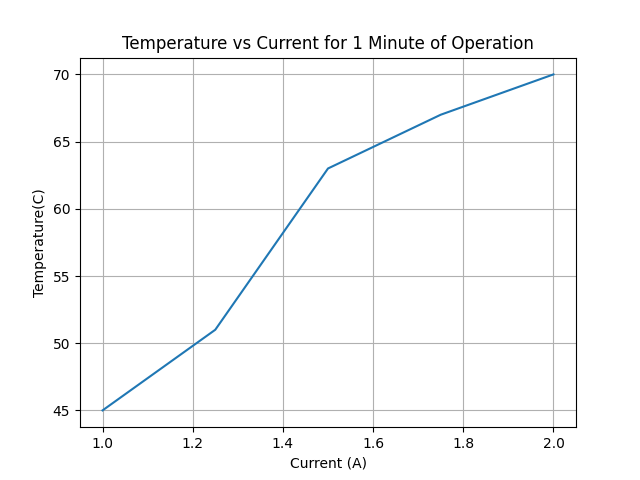
Reports/grafikler/Temperature vs Current for 1 Minute of Operation.png
