kkaya674/AntiaTech/testDocument/testArchitecture/IntegrationTest.docx

# Check if DC Motor Speeds Can be Changed by Raspberry Command

# Summary

## Location & Date

## Description & Aim

## Participants

# Preconditions & Environment Requirements

Testi yapmak için gerekli preconditionlar

# Scenario

Step | Data | Expected Result | Actual Result
