kkaya674/AntiaTech/Others/MotorSürücü/MotorS_r_c__Ilk/MotorS_r_c__Ilk.ino

int Enable_B = 11;
int inputB1 = 6;
int inputB2 = 9;
int inputRead = A1;
int i;
int k;
void setup()
{

Serial.begin(9600);
pinMode(Enable_B, OUTPUT);
pinMode(inputB1, OUTPUT);
pinMode(inputB2, OUTPUT);
pinMode(inputRead,INPUT);
}
void loop()
{
 

}
