kkaya674/AntiaTech/RaspiCo Codes/servoRun.py

import utime
from servo import Servo
 
s1 = Servo(21)       # Servo pin is connected to GP0
 
def servo_Map(x, in_min, in_max, out_min, out_max):
    return (x - in_min) * (out_max - out_min) / (in_max - in_min) + out_min
 
def servo_Angle(angle):
    if angle < 0:
        angle = 0
    if angle > 180:
        angle = 180
    
    s1.goto(round(servo_Map(angle,0,180,0,1024))) # Convert range value to angle value
   
