kkaya674/AntiaTech/Others/Arduino_Vibration&Servo/vibration/vibration.ino

int vibr_Pin =3;

void setup(){
  
  pinMode(vibr_Pin, INPUT); //set vibr_Pin input for measurment
  Serial.begin(9600); //init serial 9600
 // Serial.println("----------------------Vibration demo------------------------");
}
void loop(){
  long measurement =TP_init();
  delay(20);
 // Serial.print("measurment = ");
  Serial.println(measurement);
  
}

long TP_init(){
  delay(10);
  long measurement=pulseIn (vibr_Pin, HIGH);  //wait for the pin to get HIGH and returns measurement
  return measurement;
}
