kkaya674/AntiaTech/SystemIntegration/raspberryDataSend_raw.py

# sender.py
import time
import serial
ser = serial.Serial(
  port='/dev/ttyACM0', # Change this according to connection methods, e.g. /dev/ttyUSB0
  baudrate = 115200,
  parity=serial.PARITY_NONE,
  stopbits=serial.STOPBITS_ONE,
  bytesize=serial.EIGHTBITS,
  timeout=1
)
msg = "dsadasd"
i = 0
while True:
    i+=1
    print("Counter {} - Hello from Raspberry Pi".format(i))
    ser.write('selamunaleyküm ey müslümanlar'.encode('utf-8'))
    time.sleep(2)
