kkaya674/AntiaTech/TableTennisBallTracker/measureTable.py

from time import sleep
import cv2
import numpy as np
import globalVariable as g



def initCalibration():
    # TO DO: automaticaly calibrate the table with line detection algorithms in the future
    g.keyPoints = {
                0:"Top Left Corner",
                1:"Top Right Corner",
                2:"Bottom Left Corner",
                3:"Bottom Right Corner",

                4:"Middle Left Corner",
                5:"Middle Right Corner",
                6:"Top Middle Line End Corner",
                7:"Bottom Middle Line End Corner",
                8:"Calibration Done :)"
                }
    g.keyPts = np.zeros((8,2))
    g.iterator = 0
    g.lastCursor = (0,0)


def getPixelInfo(event,x,y,flags,param):
    if g.iterator == 8:
        g.lastCursor = (x,y)
        return
    if event == cv2.EVENT_RBUTTONDOWN:
        g.iterator = g.iterator-1
        g.keyPts.pop()
    elif event == cv2.EVENT_LBUTTONDOWN:
        g.keyPts[g.iterator,0] = x
        g.keyPts[g.iterator,1] = y
        g.iterator = g.iterator+1
        
def gradientDescent( pts ):
    x = pts[:,0] // 5
    y = pts[:,1] // 5
    X, Y = np.meshgrid(x, y, copy=False)   

    X = X.flatten()
    Y = Y.flatten()

    zx = np.array([0,152,0,152 , 0 , 152,76 , 76]) 
    zy = np.array([0,0,274,274 , 137,137,102,172]) 
    Zx, Zy = np.meshgrid(zx, zy, copy=False)

    A = np.array( [X*0+1, X, Y, X**2, X**2*Y, X**2*Y**2, Y**2, X*Y**2, X*Y] ).T
    B = Zx.flatten()
    C = Zy.flatten()

    coeffx, r, rank, s = np.linalg.lstsq(A, B )
    coeffy, r, rank, s = np.linalg.lstsq(A, C)

    return coeffx,coeffy

def calibrate(test = 0):

    cv2.namedWindow(winname="Calibrate")
    cv2.setMouseCallback("Calibrate",getPixelInfo)

    cam = cv2.VideoCapture(g.camSource)
    ret, frame = cam.read()
    if ret == 0:
        print("Can't get the feed")
        exit()

    # CALIBRATION WITH USER INPUT
    calibration = True
    while True:
        cv2.rectangle( img=frame , pt1=(10,10) , pt2=(600,30), color = (255,255,255), thickness = 30 )  # bu fonksiyonda sıkıntı yok
        cv2.putText(img=frame , text=g.keyPoints[g.iterator],org=(10,30),fontFace=cv2.FONT_HERSHEY_TRIPLEX, fontScale=1, color=(0, 0, 0),thickness=1)
        cv2.imshow("Calibrate",frame)
        if g.iterator >=8 : 
            break
            #for points in keyPts:
                #cv2.circle(frame,tuple(points.astype(int)),10,(0,0,255),5)
                # TO DO: start a timer for 5 sec and set the calibration as a result
                #pass
        if cv2.waitKey(1)  & 0xFF == 27:
            break
    g.coefficientX,g.coefficientY = gradientDescent(g.keyPts) 
    cam.release()
    
    if test :
        # TEST WHETHER CALCULATIONS ARE CORRECT
        cam = cv2.VideoCapture(g.camSource)
        ret, frame = cam.read()
        while True:
            X = g.lastCursor[0]//5
            Y = g.lastCursor[1]//5
            cursorMatrix = np.array([X*0+1, X, Y, X**2, X**2*Y, X**2*Y**2, Y**2, X*Y**2, X*Y]).T
            xLocation = np.matmul( g.coefficientX , cursorMatrix )
            yLocation = np.matmul( g.coefficientY , cursorMatrix )
            cv2.rectangle( img=frame , pt1=(10,10) , pt2=(600,30), color = (255,255,255), thickness = 30 )  
            cv2.putText(img=frame , text= str(int(xLocation))+","+str(int(yLocation))      ,org=(10,30),fontFace=cv2.FONT_HERSHEY_TRIPLEX, fontScale=1, color=(0, 0, 0),thickness=1)

            cv2.imshow("Calibrate",frame)
            if cv2.waitKey(10)  & 0xFF == 27:
                break
    cv2.destroyAllWindows()



"""
# TEST WHETHER CALCULATIONS ARE CORRECT
ret, frame = cam.read()
while False:
    X = lastCursor[0]
    Y = lastCursor[1]
    cursorMatrix = np.array([X*0+1, X, Y, X**2, X**2*Y, X**2*Y**2, Y**2, X*Y**2, X*Y]).T
    xLocation = np.matmul( coefficientX , cursorMatrix )
    yLocation = np.matmul( coefficientY , cursorMatrix )
    cv2.rectangle( img=frame , pt1=(10,10) , pt2=(600,30), color = (255,255,255), thickness = 30 )  
    cv2.putText(img=frame , text= str(int(xLocation))+","+str(int(yLocation))      ,org=(10,30),fontFace=cv2.FONT_HERSHEY_TRIPLEX, fontScale=1, color=(0, 0, 0),thickness=1)

    cv2.imshow("Calibrate",frame)
    if cv2.waitKey(10)  & 0xFF == 27:
        break
"""
