kkaya674/AntiaTech/RaspiCo Codes/lcdCode.py

# Source: Electrocredible.com, Language: MicroPython
import utime
import machine
from machine import Pin,I2C
from lcd_api import LcdApi
from pico_i2c_lcd import I2cLcd

I2C_ADDR     = 0x3f
I2C_NUM_ROWS = 2
I2C_NUM_COLS = 16


i2c = I2C(0, sda=machine.Pin(16), scl=machine.Pin(17), freq=40000)
lcd = I2cLcd(i2c, I2C_ADDR, I2C_NUM_ROWS, I2C_NUM_COLS)    



def writeStr(str1,str2):
    lcd.clear()
    lcd.move_to(0,0)
    lcd.putstr(str1)
    lcd.move_to(0,1)
    lcd.putstr(str2)
    
    

    
