kkaya674/AntiaTech/TableTennisBallTracker/globalVariable.py

HOST =0
PORT =0
client_socket =0


keyPoints = 0         
keyPts = 0
iterator = 0
lastCursor = 0
coefficientX = 0
coefficientY = 0
cam = 0
frame = 0

prevDown = 0
prevBottom = 0
kernel = 0
pts = 0


website = "http://192.168.137.188:4747/video"
usb=1
webcam=0
file = "resources/tableTennisBall.mp4"
bufferSize = 20
camSource = file
