kkaya674/AntiaTech/(commit log)

2022-12-01 Motor sürücü ilk basit kod eklendi
2022-12-03 Raspberry kutu ve namlu ucu çizimi eklendi
    [namluUcu.stl, rpi2-bottom.stp, rpi2-bottom_100mm-vesa_netfabb.stl, rpi2-bottom_8020_netfabb.stl, rpi2-top.stp, rpi2-top_25mm-fan_netfabb.stl, rpi2-top_30mm-fan_netfabb.stl, rpi3-bottom.stp]
2022-12-03 alt taban-delikli
    [altTaban.stl]
2022-12-05 alt taban
    [altTaban.stl]
2022-12-06 yeni namlu ucu eklendi
    [yeniNamlu.stl]
2022-12-06 alt taban desteği çizimi eklendi
    [VidaCarkiv.stl]
2022-12-07 Some updates on test document
    [motorYuva.stl]
2022-12-07 changes in testDocument
    [alttaban_filled v1 (2).stl, alttabanson.stl]
2022-12-09 Introduction is added
    [namluBaglanti.stl, namluKovayaGiren.stl, namluUcuSon.stl, tekerJant.stl]
2022-12-09 servo motor tests
    Added servo motor unit test and feature test files
2022-12-18 deneme kodu
    [yeniNamlu_obj_raw.prt, yeniNamlu_obj_raw.stl, yeniNamlu_obj_raw_1.stl]
2022-12-18 Add Arduino Codes
    added Arduino codes for servo motor, step motor, vibration sensors
    [servo_raspberry.ino, servostronger.ino, stepmotor.ino, vibration.ino]
2022-12-19 Minor change in motor driver code
    [namlıKovaBaglanti.stl, yeniNamlu_obj_raw.prt]
2022-12-21 Minor changes in test document
    [alttaban_filled v1 (2).stl]
2022-12-27 Cdr started
    [birlesiknamlu.stl, yeniNamlu_obj_raw.stl]
2023-03-21 raspi pico codes are added
    [yeniNamlu_obj_raw.prt]
2023-03-27 new MotorDrive.py code is added, main.py is changed
2023-04-05 Vertical movement sample code is added
2023-04-25 new raspi codes
    [yeniNamluBaglanti1.stl, yeniNamluBaglanti3.stl, yeniyuvaprt.prt]
2023-04-30 raspi codes servolar eklendi
2023-05-08 motor yuvası
    [motor yuvası vertical v3.stl]
2023-05-10 control algoritm
    [yeniNamluBaglanti1.stl, yeniNamluBaglanti3.stl, yeniyuvaprt.prt]
2023-05-13 Repo düzenlendi
    [3D_CAD_model_Training_Buddy v4.f3d, 3D_CAD_model_Training_Buddy v8.f3d, AltTaban.stl, DiskMotoruYatagi v1.stl, NamluKoprusu v0.stl, VidaCarkiv1.stl, alttaban_filled v1 (2).stl, alttabanson.stl]
2023-05-17 step motor is ready for run
2023-05-17 servoCodes are ready for run
2023-05-23 calibration is done for servo1
2023-05-23 Toggle LED
2023-05-24 demo day sensor ultrasonic threshold update
2023-05-27 networkscan kodu ve yeni çizimler eklendi
    [motoryuva2.stl, namlu2.stl, namluBirlesimi.stl, namluUcutube.prt, namluUcutube_1.stl, namluUcutube_2.stl, namlubirlesimi.prt, yeniNamlu.prt]
2023-06-04 hall effect kodu eklendi
2023-06-06 step commented out, vibration ser fixed, IU subtract 2 done
    [Update_Array_v15.py]
